michaelshiloh/telepresence/illustratorFiles/README.md

Here is the first version of the files. It does not include placement holes for the screen and it will be modified to allow for improvements and integration of further components.
