michaelshiloh/telepresence/images/image10.png

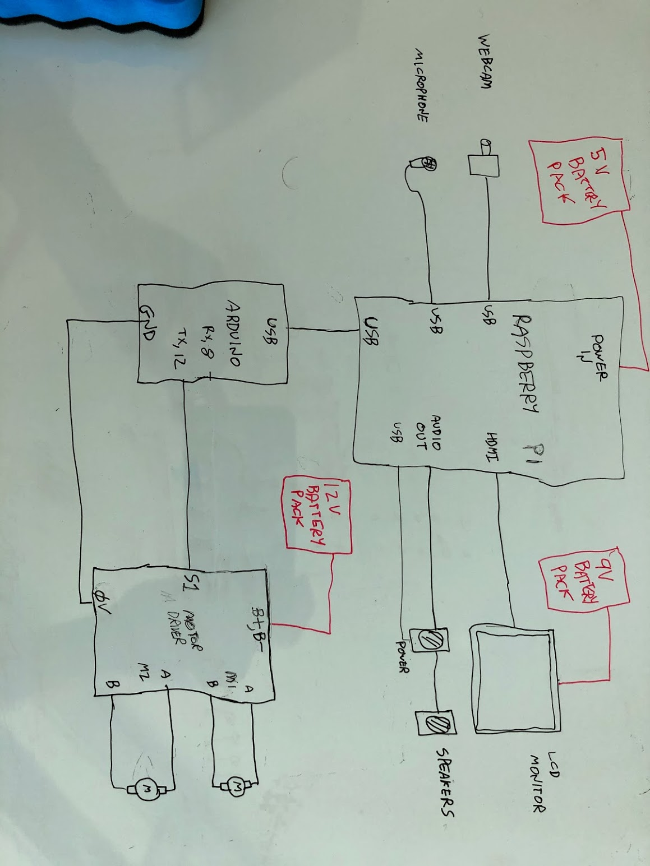
images/image10.png
