michaelshiloh/telepresence/parts.md

# Parts list for the telepresence robot

## Adafruit

- Raspberry Pi model 3B+  
- Raspberry Pi camera  
- Screen  
- microphone  
- USB console thingy  
- level shifters for interfacing with Arduino  

## SuperDroidRobots

**Motors**  
- Qty 2 TD-044-240 IG42 24VDC 240 RPM Gear Motor with Encoder $59.95 $119.90  
	(these were quite fast, might try a slower motor next time)   
- Qty 2 TD-044-122 IG42 24VDC 122 RPM Gear Motor with Encoder $61.95 $123.90  
- Qty 1 TE-183-002 Dual LS7366R Quadrature Encoder Buffer $45.68 
- Qty 2 TE-305-003 IG42 IG52 Encoder Connector $0.95 $1.90  

**Motor controller**  
- Qty 1 TE-091-212 Sabertooth Dual 12A Motor Driver $79.99 $79.99  

**Wheel assemblies**  
- Qty 1 TD-158-008 ATR Wheel Shaft Set Pair 8mm Bore - 6 inch pneumatic $66.32 $66.32  
	This is a pair of 6 inch pneumatic rubber tires with steel rims and a 1/2" steel shaft, 1/2" ID ball bearing for additional support, bored to accept 8mm motor shaft. Includes: 2 pneumatic wheels, shafts, bearings, collars and hardware.

**Motor Mounting Hardware**  
- Qty 2 TD-056-342 Motor Mount Tube - IG32 or IG42 SB $26.00 $52.00      
- Qty 2 TD-053-042 Motor Mount Plate - IG42 $3.45 $6.90  
- Qty 1 TD-166-000 IG32 and IG42 Motor Plate Hardware Kit - $3.95 $7.90  
- Qty 1 TD-165-412 M4 Steel Mounting Screw, 12mm Length, Pan Head, Phillips Drive (Pack of 16) $1.29 $2.58  

## Power

- Three portable chargers (USB battery packs) (one for Raspberry Pi and
	 Arduino, two in series for the LCD screen)
- For the motors: 
	- 12V sealed lead acid battery (gel cell)
	- 11 V lithium cells, charger, and connector:
		- Turnigy E3 Compact 2S/3S Lipo Charger 100-240v (UK Plug)		1	$14.22	$14.22		https://hobbyking.com/en_us/turnigy-e3-compact-2s-3s-lipo-charger-100-240v-uk-plug.html  
		- Turnigy 2200mAh 3S 40C Lipo Pack		1	$16.63	$16.63		https://hobbyking.com/en_us/turnigy-2200mah-3s-40c-lipo-pack.html  
		- Nylon XT60 Connectors Male/Female (5 pairs) GENUINE		1	$2.90	$2.90		https://hobbyking.com/en_us/nylon-xt60-connectors-male-female-5-pairs-genuine.html
