michaelshiloh/telepresence/src/video_streaming_with_flask_example/main.py

#!/usr/bin/env python
#
# Project: Video Streaming with Flask
# Author: Log0 <im [dot] ckieric [at] gmail [dot] com>
# Date: 2014/12/21
# Website: http://www.chioka.in/
# Description:
# Modified to support streaming out with webcams, and not just raw JPEGs.
# Most of the code credits to Miguel Grinberg, except that I made a small tweak. Thanks!
# Credits: http://blog.miguelgrinberg.com/post/video-streaming-with-flask
#
# Usage:
# 1. Install Python dependencies: cv2, flask. (wish that pip install works like a charm)
# 2. Run "python main.py".
# 3. Navigate the browser to the local webpage.
from flask import Flask, render_template, Response, request
from camera import VideoCamera

import serial
arduino = serial.Serial('/dev/ttyACM0', 9600, timeout=.1)

app = Flask(__name__)

@app.route('/')
def index():
    return render_template('index.html')

def gen(camera):
    while True:
        frame = camera.get_frame()
        yield (b'--frame\r\n'
               b'Content-Type: image/jpeg\r\n\r\n' + frame + b'\r\n\r\n')

@app.route('/video_feed')
def video_feed():
    return Response(gen(VideoCamera()),
                    mimetype='multipart/x-mixed-replace; boundary=frame')

@app.route('/forward', methods=['POST'])
def forward():
    return "cool, you are moving forward"
    # return render_template('index.html')

@app.route('/left', methods=['POST'])
def left():
    return "cool, you are moving left"
    # return render_template('index.html')

@app.route('/right', methods=['POST'])
def right():
    return "cool, you are moving right"
    # return render_template('index.html')

if __name__ == '__main__':
    app.run(host='0.0.0.0', port=80, debug=True)
