michaelshiloh/telepresence/(commit log)

2018-11-06 got node.js and control of pin13 led from phone!
2018-11-06 added arduino sketches
2018-11-09 moved arduino sketches to src
2018-11-09 added simple arduino pi communication example using python
2019-11-09 added superdroid robots order and Turnigy battery, charger, and connector
2019-12-30 slower motor and added mounting plates and encoder
2019-12-30 added slower motor part number
2020-02-15 moved tx pin, untested
